AlexUg/kicad-libs/(list of files, cad)

Other CAD files:
DS3231_HW-84/DS3231_HW-84-B_SilkS.dxf
DS3231_HW-84/DS3231_HW-84-F_SilkS.dxf
