AlexUg/kicad-libs/USB_Relay_Module/USB_Relay_Module.kicad_pcb

## KiCad design USB_Relay_Module/USB_Relay_Module.kicad_pcb (2021-06-24)

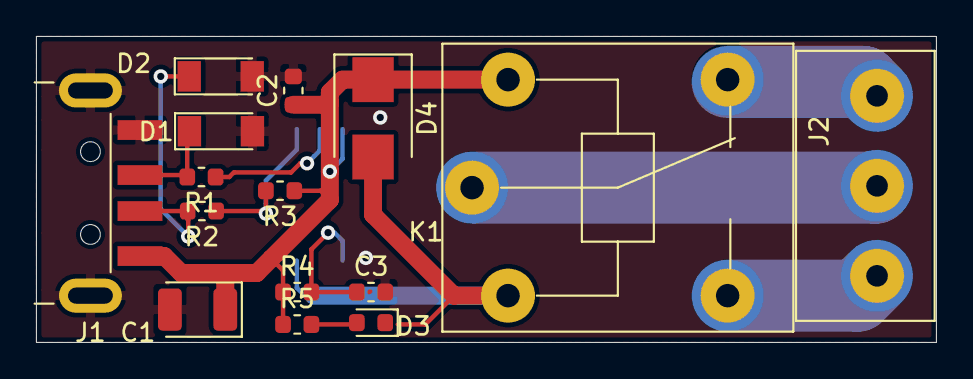
[picture p1: board USB_Relay_Module.kicad_pcb from above]

Board: 2 copper layers, 50.0 x 17.0 mm, 16 parts (1 on the bottom side), 12 nets.

Parts:
C1: 47uF; CP_EIA-3528-12_Kemet-T
C2, C3: 100n; C_0603_1608Metric
D1, D2: 3.6V; D_MiniMELF
D3: LED; LED_0603_1608Metric
D4: D; D_SMB
J1: USB_A; USB_A_CNCTech_1001-011-01101_Horizontal
J2: OUT; KF301_5.0_3
K1: HLS8
R1, R2: 82; R_0603_1608Metric
R3, R5: 880; R_0603_1608Metric
R4: 10k; R_0603_1608Metric
U1: ATtiny45-20SU; SOIJ-8_5.3x5.3mm_P1.27mm

Connections:
02: J2.2, K1.5
03: J2.1, K1.3
+5V: C1.1, C2.1, D4.1, J1.1, K1.1, R3.1, R4.1, R5.1, U1.8
D+: R1.1, U1.7
D-: R2.1, R3.2, U1.6
GND: C1.2, C2.2, C3.2, D1.2, D2.2, J1.4, J1.5, U1.4
unnamed: D1.1, J1.3, R1.2
unnamed: D2.1, J1.2, R2.2
unnamed: D3.2, R5.2
O1: J2.3, K1.2
Rel: D3.1, D4.2, K1.4, U1.3
Reset: C3.1, R4.2, U1.1
