AlexUg/kicad-libs/DS3231_HW-84/DS3231_HW-84.kicad_pcb

## KiCad design DS3231_HW-84/DS3231_HW-84.kicad_pcb (2021-03-27)

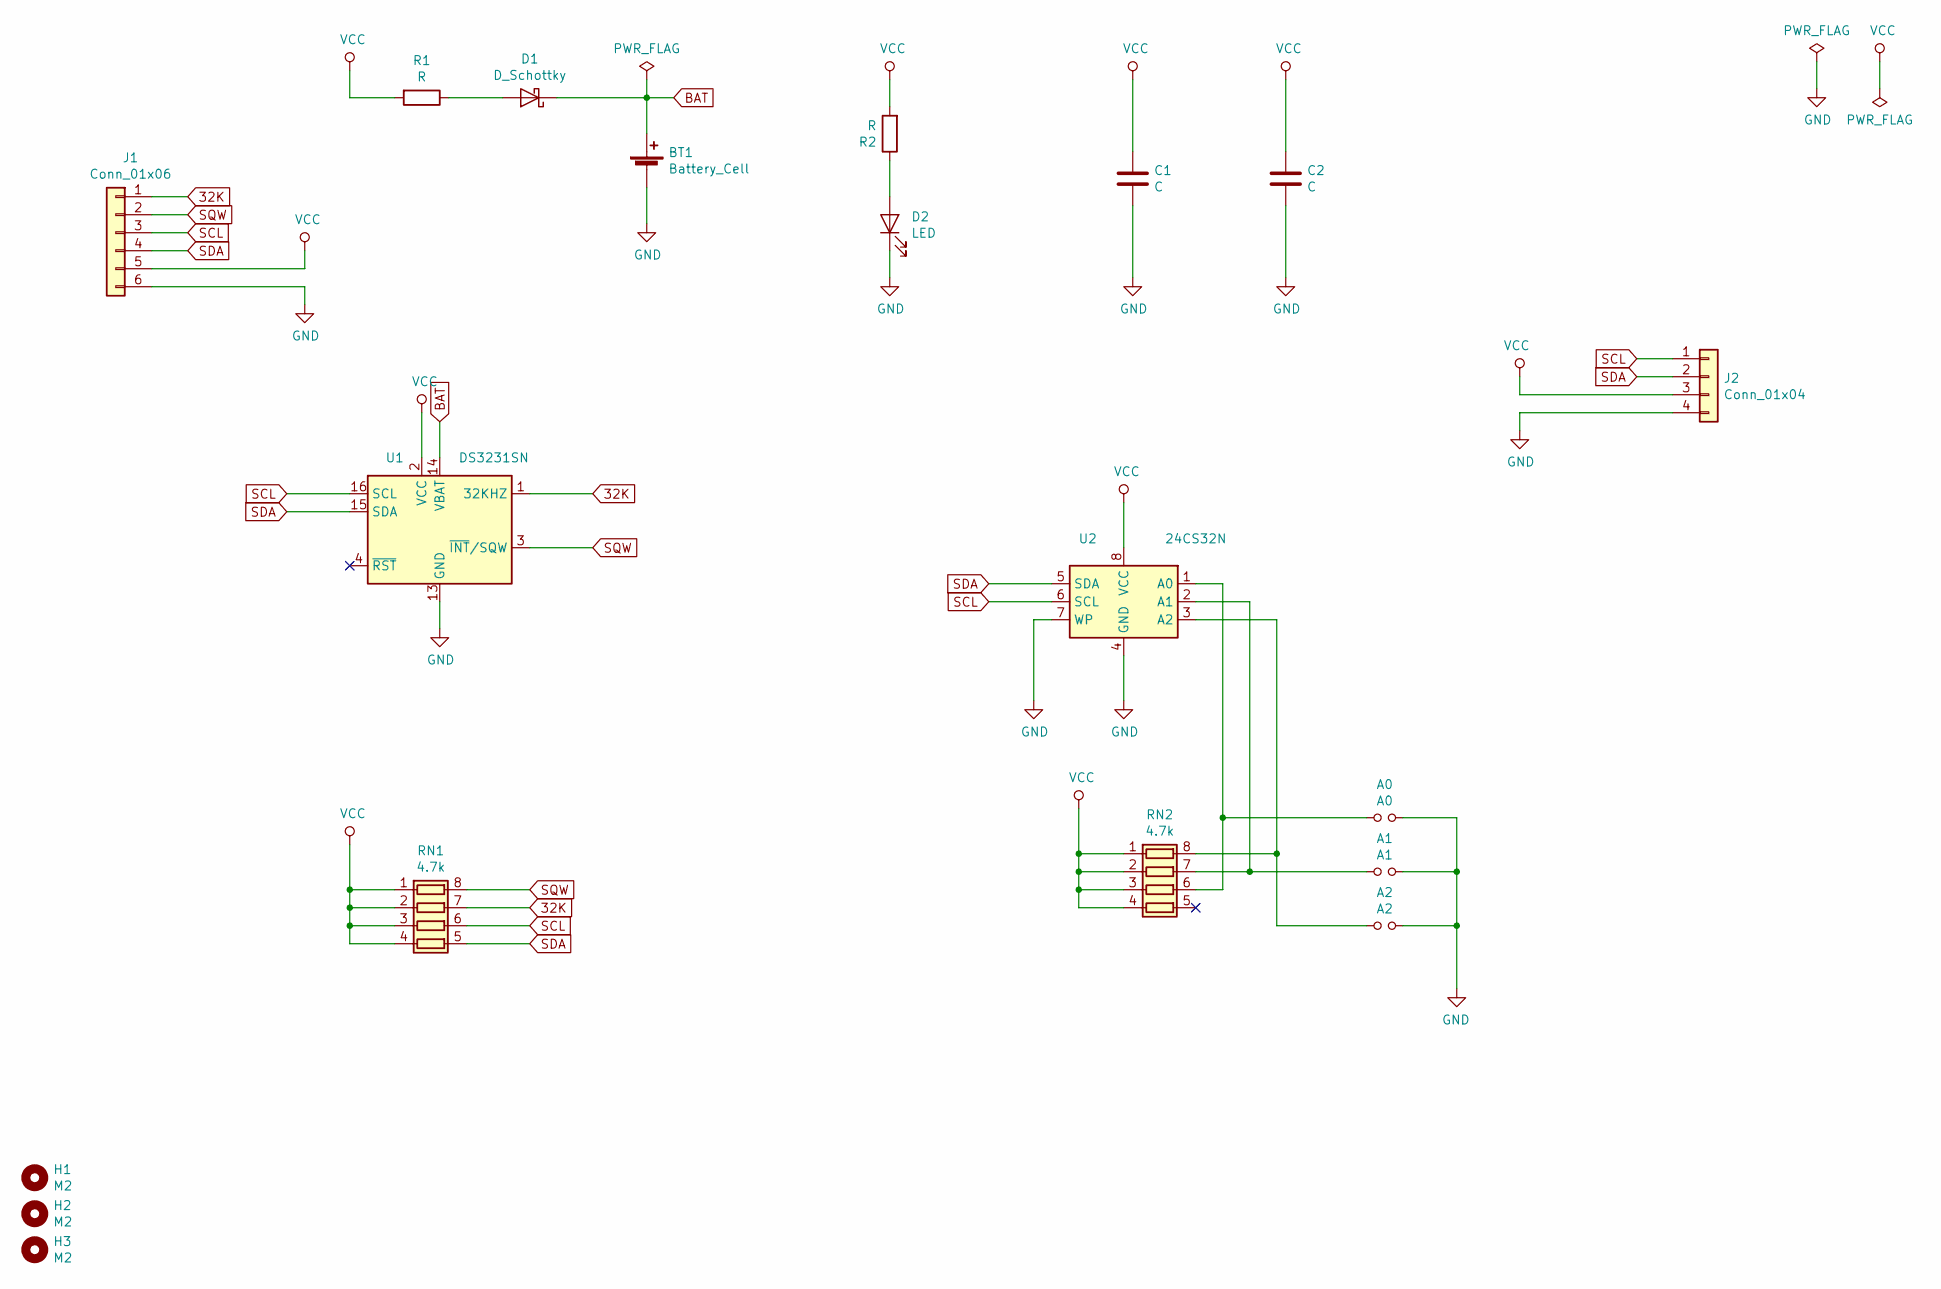
[picture p2: schematic DS3231_HW-84.sch]

Parts:
A0: A0; SolderJumper-2_P1.3mm_Open_Pad1.0x1.5mm
A1: A1; SolderJumper-2_P1.3mm_Open_Pad1.0x1.5mm
A2: A2; SolderJumper-2_P1.3mm_Open_Pad1.0x1.5mm
BT1: Battery_Cell; CH224-2032LF
C1, C2: C; C_0805_2012Metric
D1: D_Schottky; D_MELF
D2: LED; LED_0805_2012Metric
H1, H2, H3: M2; MountingHole_2.2mm_M2
J1: Conn_01x06; PinHeader_1x06_P2.54mm_Vertical
J2: Conn_01x04; PinHeader_1x04_P2.54mm_Vertical
R1, R2: R; R_0805_2012Metric
RN1, RN2: 4.7k; R_Array_Convex_4x0603
U1: DS3231SN; SOIC-16W_7.5x10.3mm_P1.27mm
U2: 24CS32N; SOIC-8_3.9x4.9mm_P1.27mm

Connections:
32K: J1.1, RN1.7 (R2.2), U1.1 (32KHZ)
BAT: BT1.1 (+), D1.1 (K), U1.14 (VBAT)
GND: A0.2, A1.2, A2.2, BT1.2 (-), C1.2, C2.2, D2.1 (K), J1.6, J2.4, U1.5 (GND), U1.6 (GND), U1.7 (GND), U1.8 (GND), U1.9 (GND), U1.10 (GND), U1.11 (GND), U1.12 (GND), U1.13 (GND), U2.4 (GND), U2.7 (WP)
unnamed: A0.1, RN2.6 (R3.2), U2.1 (A0)
unnamed: A1.1, RN2.7 (R2.2), U2.2 (A1)
unnamed: A2.1, RN2.8 (R1.2), U2.3 (A2)
unnamed: D1.2 (A), R1.1
unnamed: D2.2 (A), R2.1
SCL: J1.3, J2.1, RN1.6 (R3.2), U1.16 (SCL), U2.6 (SCL)
SDA: J1.4, J2.2, RN1.5 (R4.2), U1.15 (SDA), U2.5 (SDA)
SQW: J1.2, RN1.8 (R1.2), U1.3 (~INT~/SQW)
VCC: C1.1, C2.1, J1.5, J2.3, R1.2, R2.2, RN1.1 (R1.1), RN1.2 (R2.1), RN1.3 (R3.1), RN1.4 (R4.1), RN2.1 (R1.1), RN2.2 (R2.1), RN2.3 (R3.1), RN2.4 (R4.1), U1.2 (VCC), U2.8 (VCC)

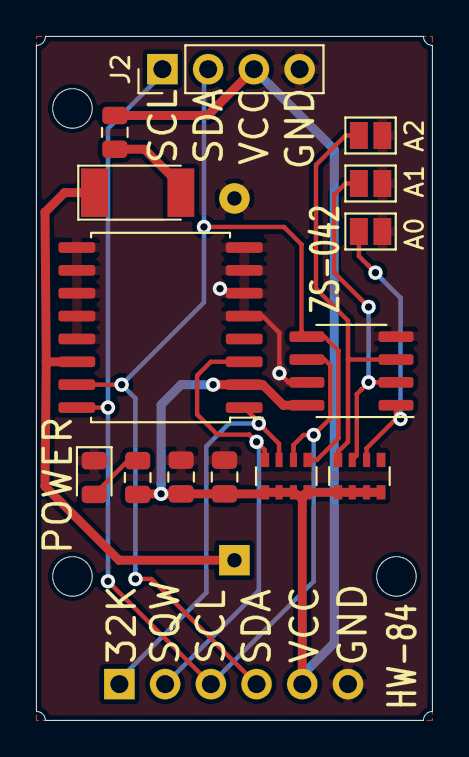
[picture p3: board DS3231_HW-84.kicad_pcb from above]

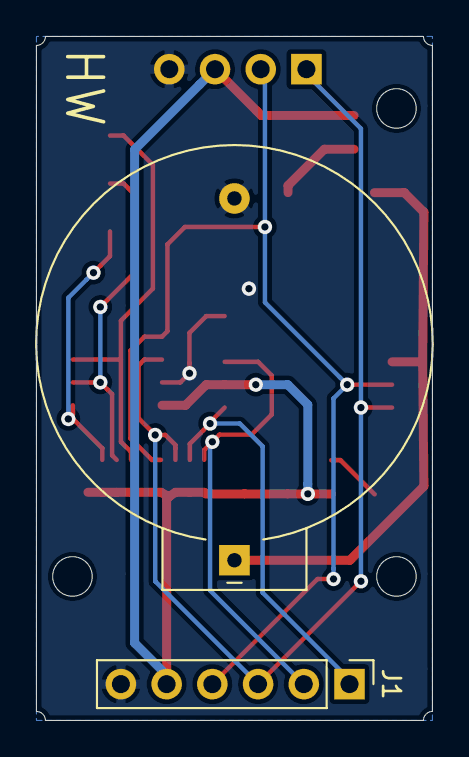
[picture p4: board DS3231_HW-84.kicad_pcb from below]

Board: 2 copper layers, 22.0 x 38.0 mm, 19 parts (2 on the bottom side), 12 nets.
