AlexUg/kicad-libs/4_Relay_Module/4_Relay_Module.kicad_pcb

## KiCad design 4_Relay_Module/4_Relay_Module.kicad_pcb (2020-01-06)

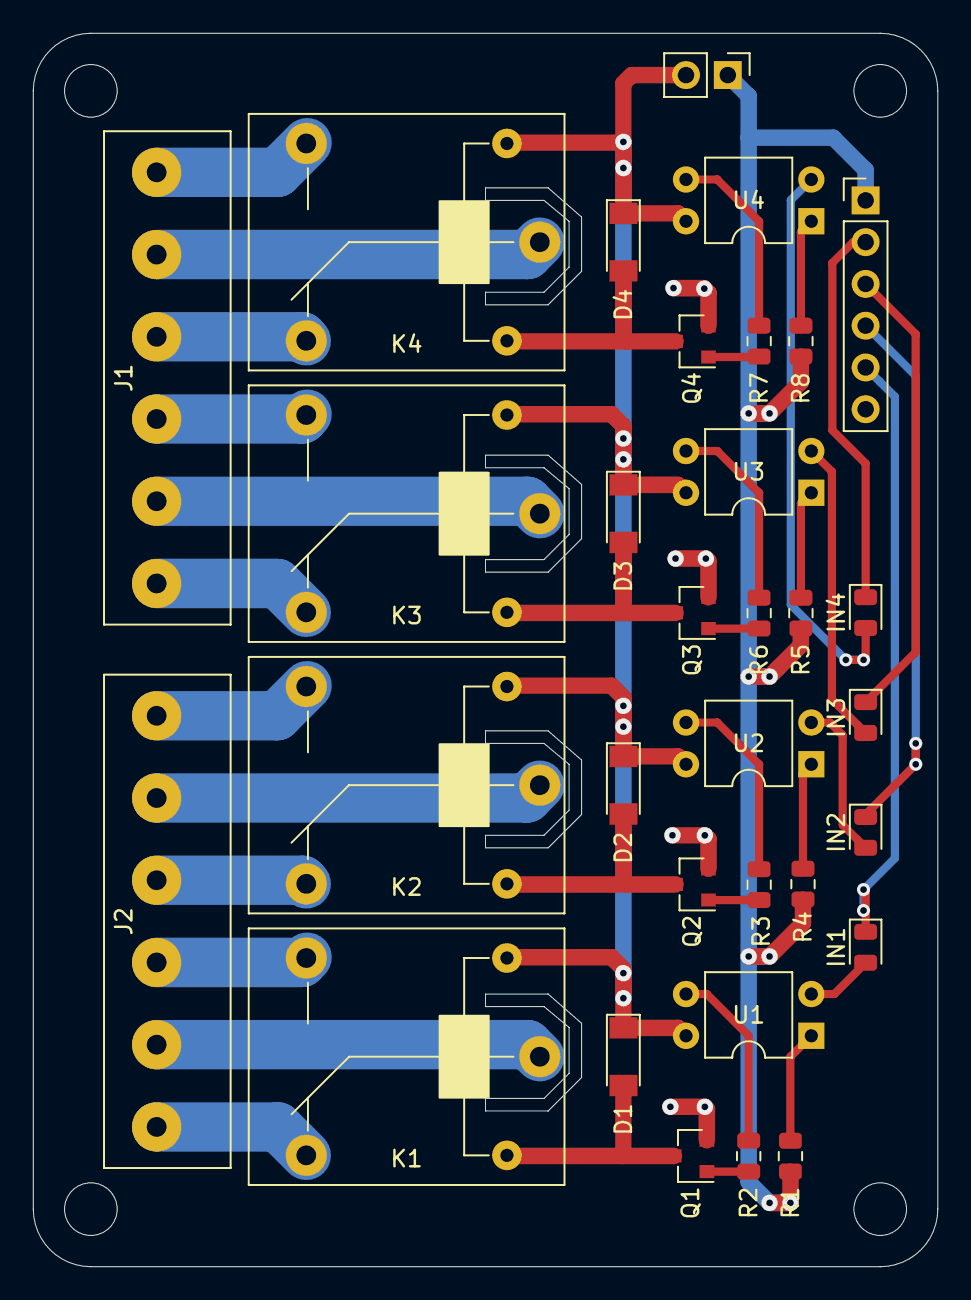
[picture p5: board 4_Relay_Module.kicad_pcb from above]

Board: 2 copper layers, 55.0 x 75.0 mm, 36 parts (0 on the bottom side), 39 nets.

Parts:
D1, D2, D3, D4: D; D_MiniMELF
H1, H2, H3, H4: MountingHole; MountingHole_3.2mm_M3
IN1, IN2, IN3, IN4: LED; LED_0805_2012Metric
J1, J2: Conn_01x06; KF301_5.0_6
J3: Conn_01x02; PinHeader_1x02_P2.54mm_Vertical
J4: Conn_01x06; PinHeader_1x06_P2.54mm_Vertical
K1, K2, K3, K4: SRD-05VDC-SL-C; SPDT_SRD_05VDC-SL-C
Q1, Q2, Q3, Q4: Q_NPN_BEC; SOT-23
R1, R4, R5, R8: 1k; R_0805_2012Metric
R2, R3, R6, R7: 510; R_0805_2012Metric
U1, U2, U3, U4: 817C; DIP-4_W7.62mm

Connections:
/relay_1/IN: IN1.1, J4.5
/relay_1/OUT_1: J2.5, K1.1
/relay_1/OUT_2: J2.6, K1.4
/relay_1/OUT_3: J2.4, K1.3
/relay_2/IN: IN2.1, J4.4
/relay_2/OUT_1: J2.2, K2.1
/relay_2/OUT_2: J2.3, K2.4
/relay_2/OUT_3: J2.1, K2.3
/relay_3/IN: IN3.1, J4.3
/relay_3/OUT_1: J1.5, K3.1
/relay_3/OUT_2: J1.6, K3.4
/relay_3/OUT_3: J1.4, K3.3
/relay_4/IN: IN4.1, J4.2
/relay_4/OUT_1: J1.2, K4.1
/relay_4/OUT_2: J1.3, K4.4
/relay_4/OUT_3: J1.1, K4.3
GND: J4.6, Q1.2, Q2.2, Q3.2, Q4.2
JD_VCC: D1.1, D2.1, D3.1, D4.1, J3.2, K1.2, K2.2, K3.2, K4.2, U1.4, U2.4, U3.4, U4.4
unnamed: D1.2, K1.5, Q1.3
unnamed: D2.2, K2.5, Q2.3
unnamed: D3.2, K3.5, Q3.3
unnamed: D4.2, K4.5, Q4.3
unnamed: IN1.2, U1.2
unnamed: IN2.2, U2.2
unnamed: IN3.2, U3.2
unnamed: IN4.2, U4.2
unnamed: Q1.1, R2.2
unnamed: Q2.1, R3.2
unnamed: Q3.1, R6.2
unnamed: Q4.1, R7.2
unnamed: R1.2, U1.1
unnamed: R2.1, U1.3
unnamed: R3.1, U2.3
unnamed: R4.2, U2.1
unnamed: R5.2, U3.1
unnamed: R6.1, U3.3
unnamed: R7.1, U4.3
unnamed: R8.2, U4.1
VCC: J3.1, J4.1, R1.1, R4.1, R5.1, R8.1
