AlexUg/kicad-libs/TinyRTC_1307/TinyRTC_1307.kicad_pcb

## KiCad design TinyRTC_1307/TinyRTC_1307.kicad_pcb (2019-12-24)

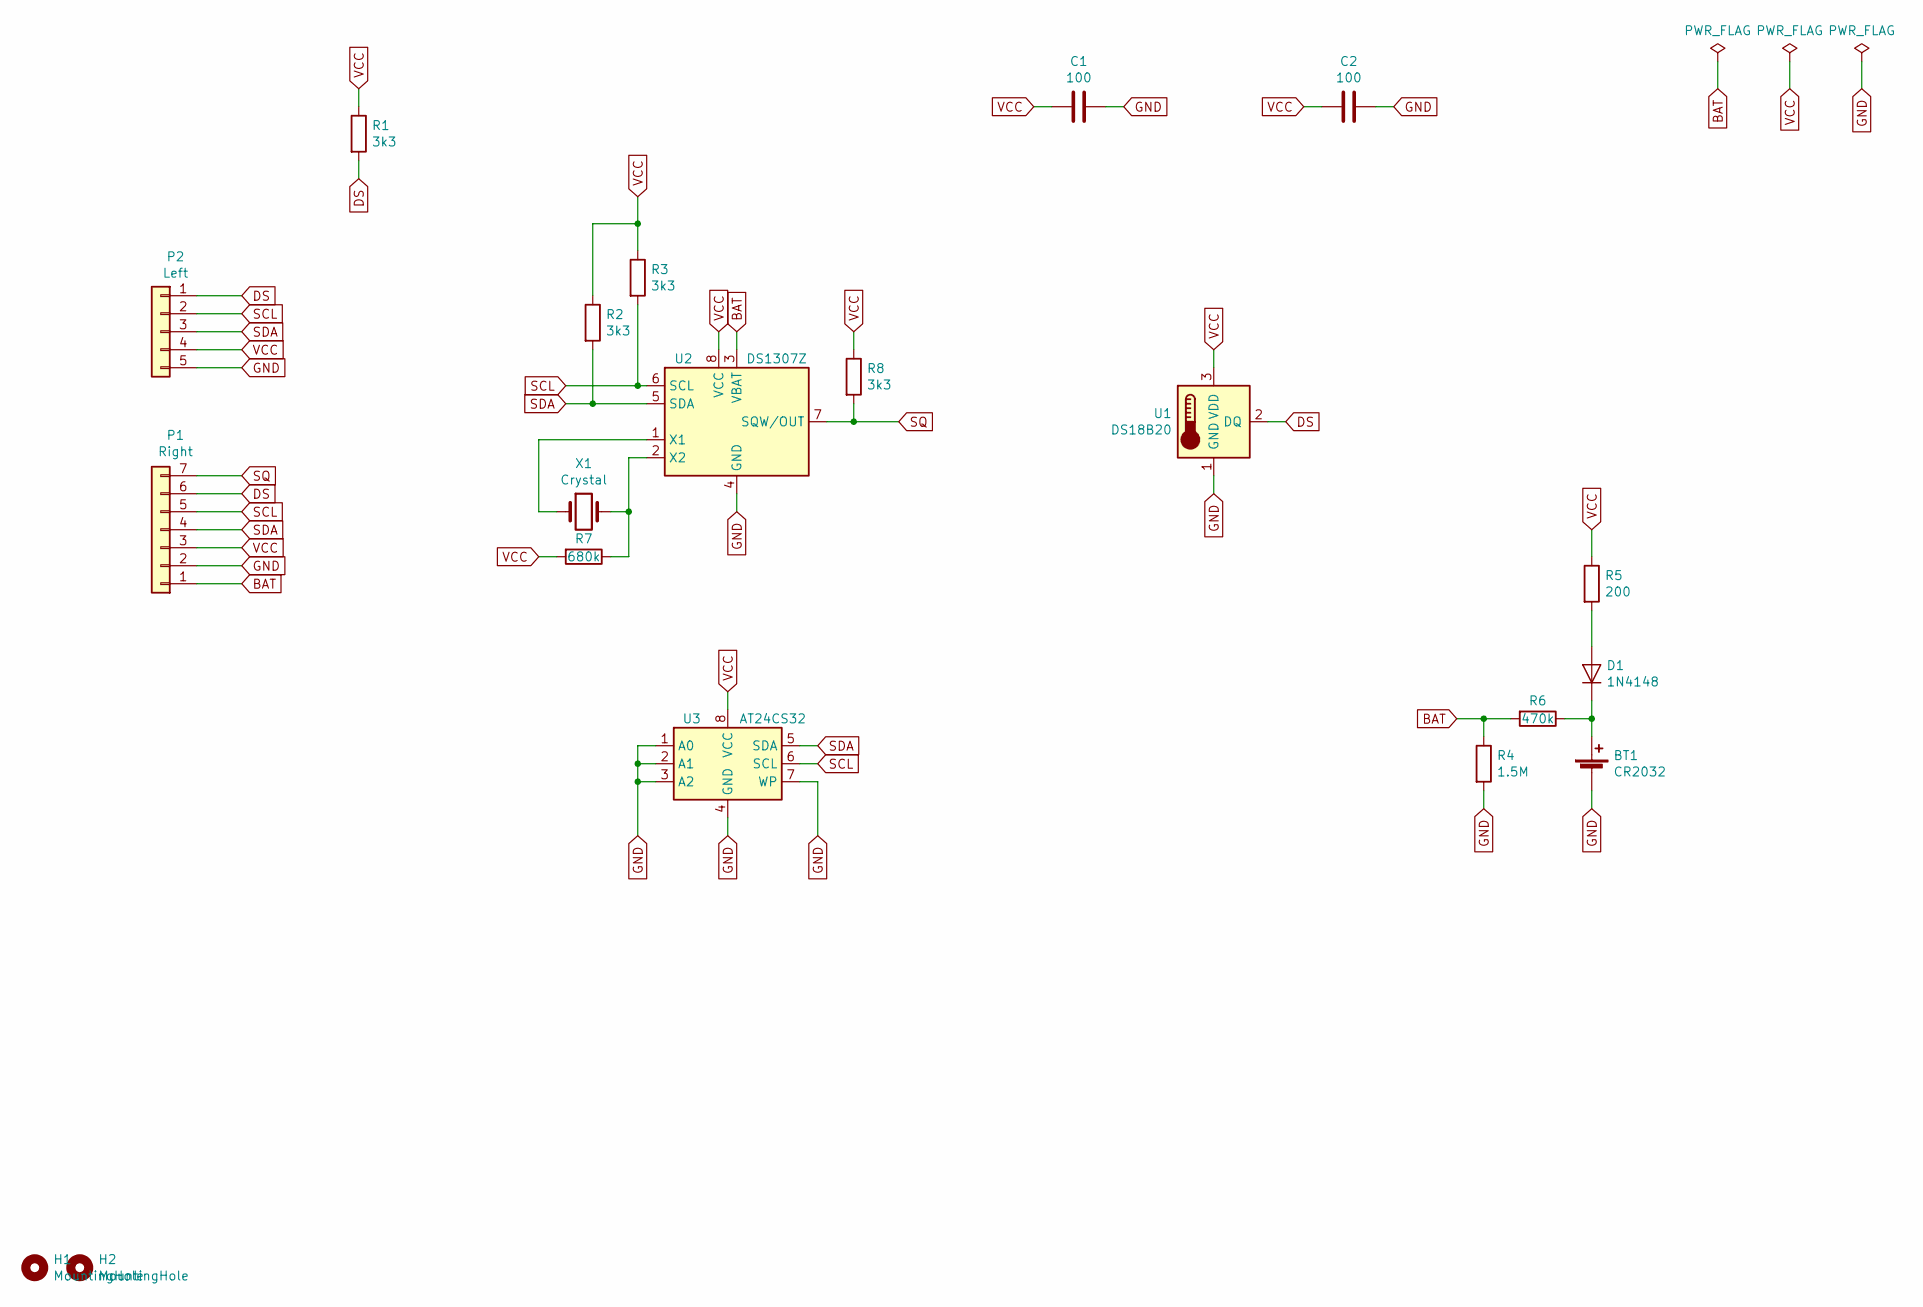
[picture p6: schematic TinyRTC_1307.sch]

Parts:
BT1: CR2032; BatteryHolder_Harwin_CR2032
C1, C2: 100; C_0805_2012Metric_Pad1.15x1.40mm_HandSolder
D1: 1N4148; D_MicroMELF_Handsoldering
H1, H2: MountingHole; MountingHole_3mm
P1: Right; PinHeader_1x07_P2.54mm_Vertical
P2: Left; PinHeader_1x05_P2.54mm_Vertical
R1, R2, R3, R8: 3k3; R_0805_2012Metric_Pad1.15x1.40mm_HandSolder
R4: 1.5M; R_0805_2012Metric_Pad1.15x1.40mm_HandSolder
R5: 200; R_0805_2012Metric_Pad1.15x1.40mm_HandSolder
R6: 470k; R_0805_2012Metric_Pad1.15x1.40mm_HandSolder
R7: 680k; R_0805_2012Metric_Pad1.15x1.40mm_HandSolder
U1: DS18B20; TO-92_Inline_Wide
U2: DS1307Z; SOIC-8_3.9x4.9mm_P1.27mm
U3: AT24CS32; SOIC-8_3.9x4.9mm_P1.27mm
X1: Crystal; Crystal_C38-LF_D3.0mm_L8.0mm_Horizontal

Connections:
BAT: P1.1, R4.1, R6.2, U2.3 (VBAT)
DS: P1.6, P2.1, R1.2, U1.2 (DQ)
GND: BT1.2 (-), C1.2, C2.2, P1.2, P2.5, R4.2, U1.1 (GND), U2.4 (GND), U3.1 (A0), U3.2 (A1), U3.3 (A2), U3.4 (GND), U3.7 (WP)
unnamed: BT1.1 (+), D1.1 (K), R6.1
unnamed: D1.2 (A), R5.2
unnamed: R7.1, U2.2 (X2), X1.2
unnamed: U2.1 (X1), X1.1
SCL: P1.5, P2.2, R3.2, U2.6 (SCL), U3.6 (SCL)
SDA: P1.4, P2.3, R2.2, U2.5 (SDA), U3.5 (SDA)
SQ: P1.7, R8.2, U2.7 (SQW/OUT)
VCC: C1.1, C2.1, P1.3, P2.4, R1.1, R2.1, R3.1, R5.1, R7.2, R8.1, U1.3 (VDD), U2.8 (VCC), U3.8 (VCC)

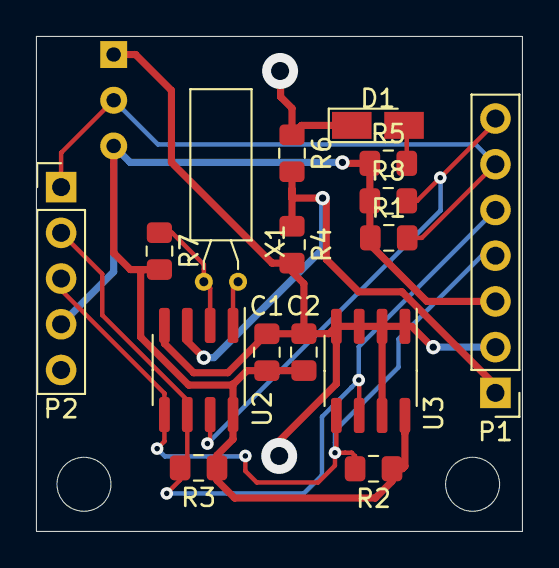
[picture p7: board TinyRTC_1307.kicad_pcb from above]

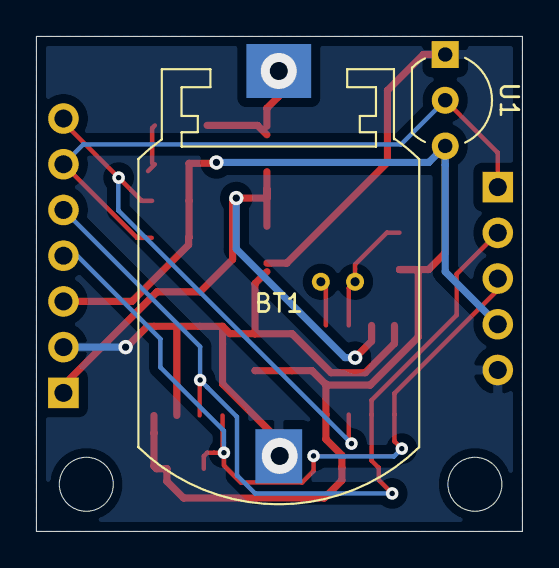
[picture p8: board TinyRTC_1307.kicad_pcb from below]

Board: 2 copper layers, 27.0 x 27.5 mm, 20 parts (2 on the bottom side), 11 nets.
