AlexUg/kicad-libs/(commit log)

2019-12-24 TinyRTC 1307 module: KiCAD project, symbol library, footprints and 3D shapes
    [TinyRTC_1307.kicad_pcb, TinyRTC_1307.sch]
2020-01-05 Footprint and 3d models for KF-30x connector were added
2020-01-05 Footprint and 3d models for SRD-05VDC-SL-C relay were added
2020-01-06 Symbol, footprint and 3d models for '4 Relay Module' were added
    [4_Relay_Module.kicad_pcb, 4_Relay_Module.sch, relay.sch]
2020-03-09 Connector_Confly/DS-1069-B_1x02_Horizontal footprint and 3D model
2020-04-17 Connector_Confly/DS-1074 was added
2020-04-19 Arduino-Nano was added
2020-06-17 Minor changes in Connector_Confly:DS-1069-B_1x02
2021-03-27 Battery CH224-2032LF was added
    [DS3231_HW-84.kicad_pcb, DS3231_HW-84.sch]
2021-03-27 DS3231_HW-84 was added
    [DS3231_HW-84-B_SilkS.dxf, DS3231_HW-84-F_SilkS.dxf, DS3231_HW-84.kicad_pcb, DS3231_HW-84.sch]
2021-06-24 Relay HLS8 was added
2021-06-24 USB Relay module was added
    [USB_Relay_Module.kicad_pcb, USB_Relay_Module.sch]
2021-07-01 USB-B-292304-1 connector was added
2021-09-12 Pololu motor driver, USB B, Arduino ProMinit were added
    [Pololu_DRV8825.kicad_pcb, Pololu_DRV8825.sch]
